Subrahmanya-Bhide/Viscometer-design-Project/Metrology Task Presentation.pdf

## AE242 : METROLOGY AND COMPUTER AIDED INSPECTION

DESIGNING AND MANUFACTURING OF A VISCOMETER

Amruth N(SC18B003), Mihir Kaswan(SC18B015), Pallav Kumar(SC18B018), Siddharth J Gantawar(SC18B029), Subrahmanya V Bhide(SC18B030).

INDIAN INSTITUTE OF SPACE SCIENCE AND TECHNOLOGY

10 May 2020

The viscosity of a fluid is a measure of its resistance to deformation at a given rate. A measure of viscosity called the coefficient of viscosity (denoted by µ) is defined as the slope of the curve between shear stress and rate of shear strain (between fluid layers)

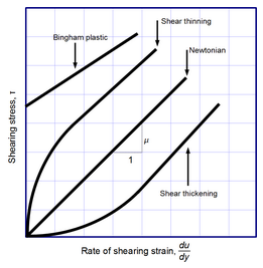
[picture p1: figure]

It is an important property of any fluid and has major implications in a variety of situations for instance the boundary layer concept which occurs in flow of air over a wing, internal flows of liquids and gases in heat exchangers and variety of other applications.

## Methodology

The methodology used by us to measure viscosity is based on the relation obatined below-Consider two cylinders one hollow and the other one solid, as shown in the below figure.

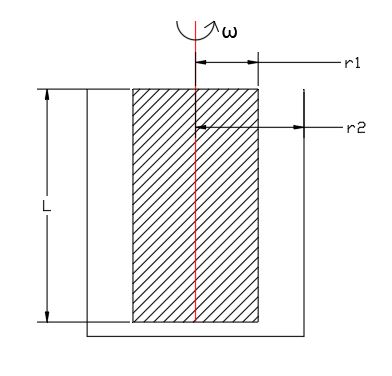
[picture p2: figure]

The radius of the inner and outer cylinder are r1 and r2 respectively. The height of the liquid being L.

When a liquid is introduced between these cylinders and the inner solid cylinder is rotated at a particular angualr speed (ω). The liquid as a virtue of its viscosity would resist the rotation of the cyliner and hence a torque msut be applied by the motor.

shear stress = µ

du
dy | (1)

shear stress = µ

ωr1
r2 − r1

(2)

dF = µ

ωr1
r2 − r1
r1Ldθ | (3)

Hence we get

τ =

Z r2

r1

rdF = µ

ωr

2
1
r2 − r1
2πr1L | (4)

Thus we get the expression

τ =

µωr

3/1 2πL
r2 − r1

(5)

Hence the expression for µ is obatined as

µ = τ

r2 − r1
ωr

3/1 2πL

(6)

## Components of the Viscometer

I NEMA 17 STEPPER MOTOR and corresponding STEPPER MOTOR DRIVER
I LOAD CELL and HX711 AMPLIFIER
I COUPLING
I INNER and OUTER CYLINDER
I PRONY BRAKE
I ARDUINO UNO
I THRUST BEARING

## PRONY BRAKE SYSTEM

I Prony Brake is a system that comprises of two blocks with semi circluar slots that together hold a shaft.
I It applies dry friction on the shafts and due to the reaction force the prony brake spins.
I By measuring the force at the free end of the prony brake using a load cell and knowing the length of the prony brake, it is possible to find the torque applied by the shaft. (https://www.youtube.com/watch?v=NIpspXaPVcs)

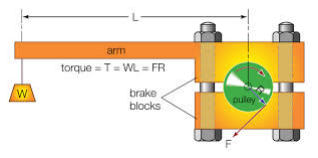
[picture p3: figure]

NEMA 17 stepper motor would be used to rotate the inner cylinder at a constant angular speed.
Specifications:
I Step Angle: 1.8

◦

I Current: 1.2 A/Phase
I Holding Torque: 5.6 kg-cm I Lead Wires: 4
I Shaft diameter: 5 mm

A TB6560 Stepper Motor Driver would be used to interface the stepper motor alog with the current source.
Specifications:
I Rated output: ± 3A ,peak 3.5A.
I Excitation Mode: synchronizing, half step, 1/8 step, 1/16 step, a maximum of 16 segments.
I Working voltage: DC 10V-35V

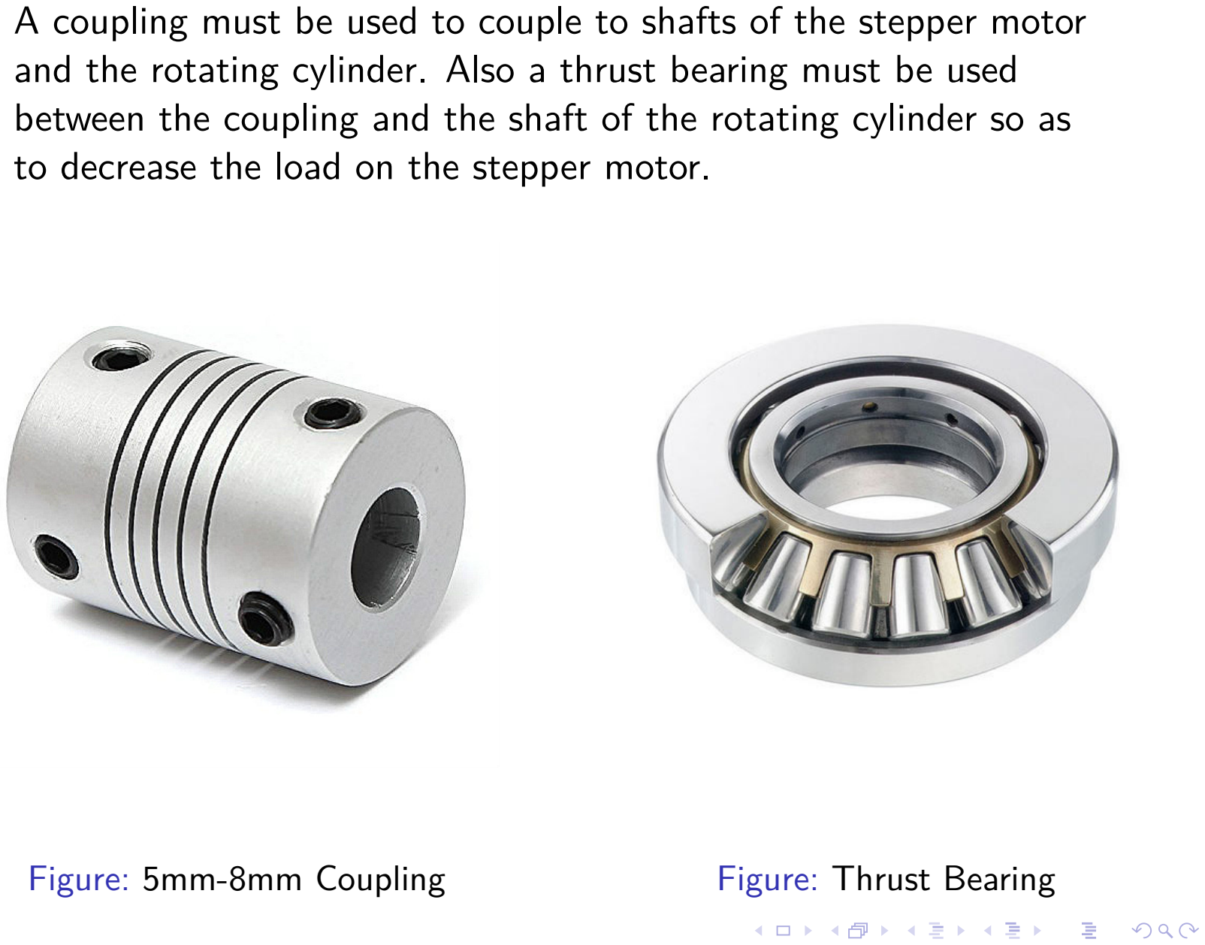
[picture p4: page 9]

A coupling must be used to couple to shafts of the stepper motor and the rotating cylinder. Also a thrust bearing must be used between the coupling and the shaft of the rotating cylinder so as to decrease the load on the stepper motor.

Figure: 5mm-8mm Coupling | Figure: Thrust Bearing

A Load cell would be used to measure the force and hence torque through the prony brake. Specifications:
I Total Size: 8 x 1.3 x 1.3cm / 3.1" x 0.5" x 0.5"(L*W*T)
I Rated Load: 0-5Kg

Also HX711 is a 24 bit ADC which load cell and is connected in between the load cell and the arduino.
The drawings of the inner cylinder, outer cylinder, the two parts of the prony brake, outer cover and the top cover are shown in the following slides respectively.

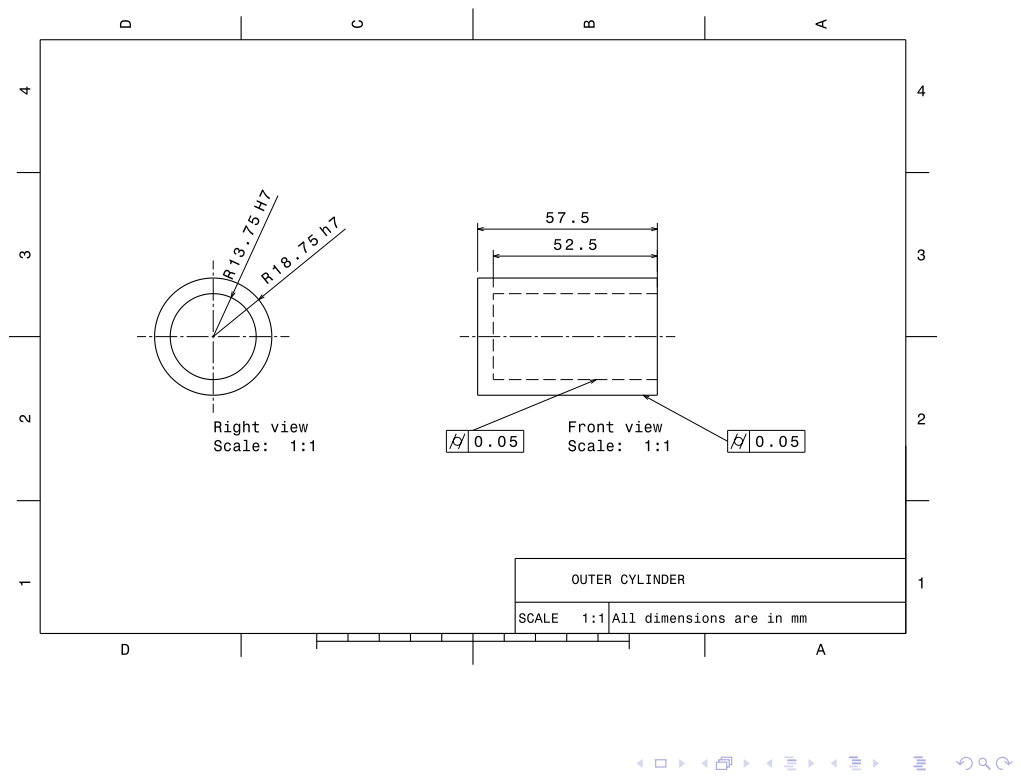
[picture p5: page 11]

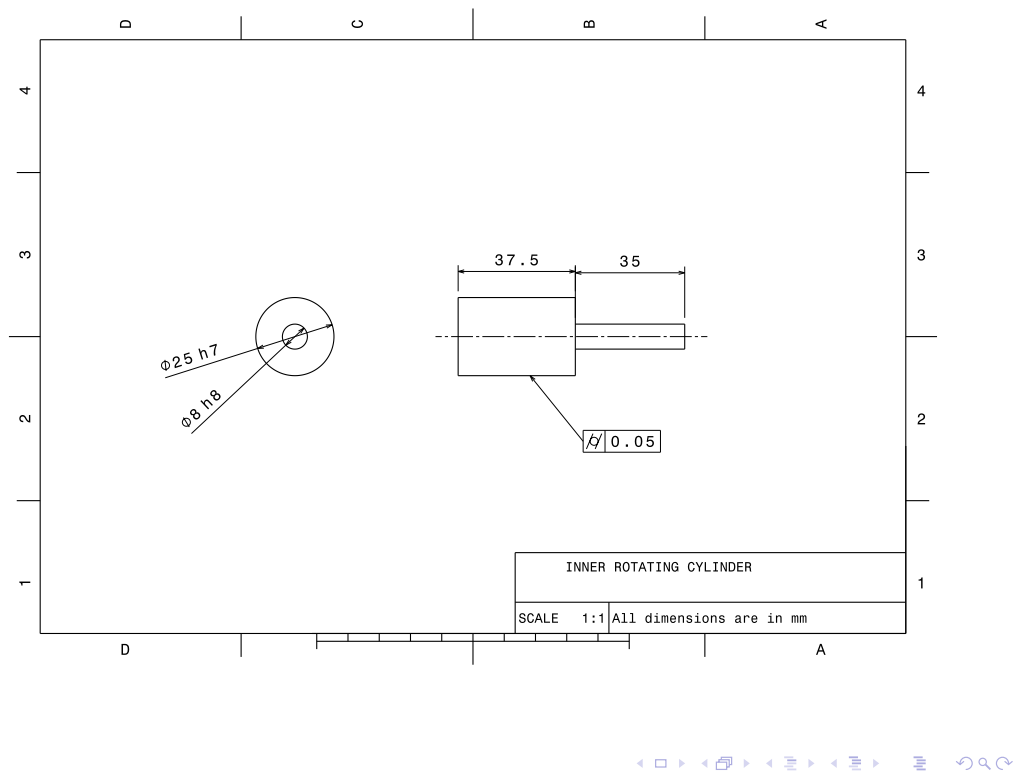
[picture p6: page 12]

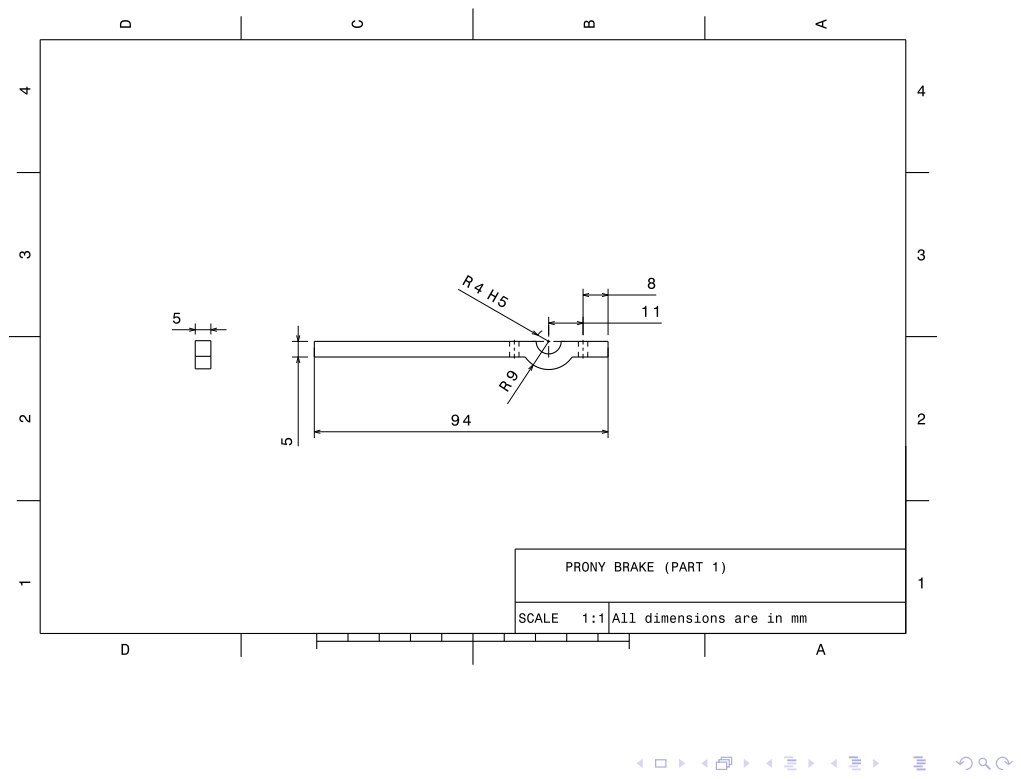
[picture p7: page 13]

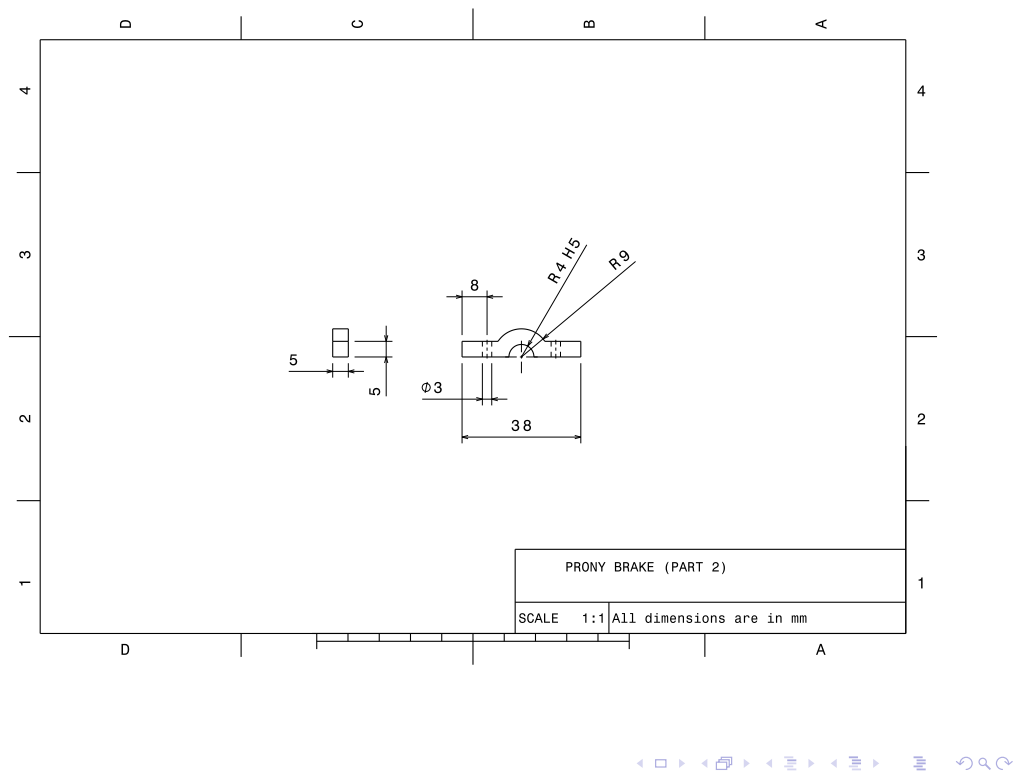
[picture p8: page 14]

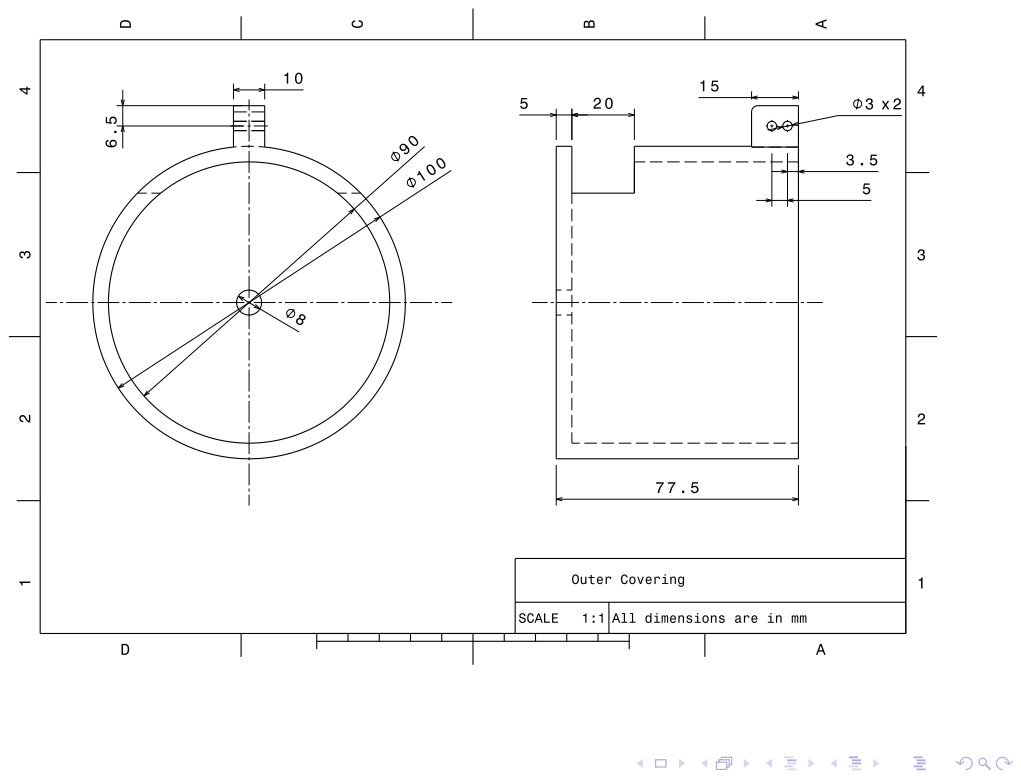
[picture p9: page 15]

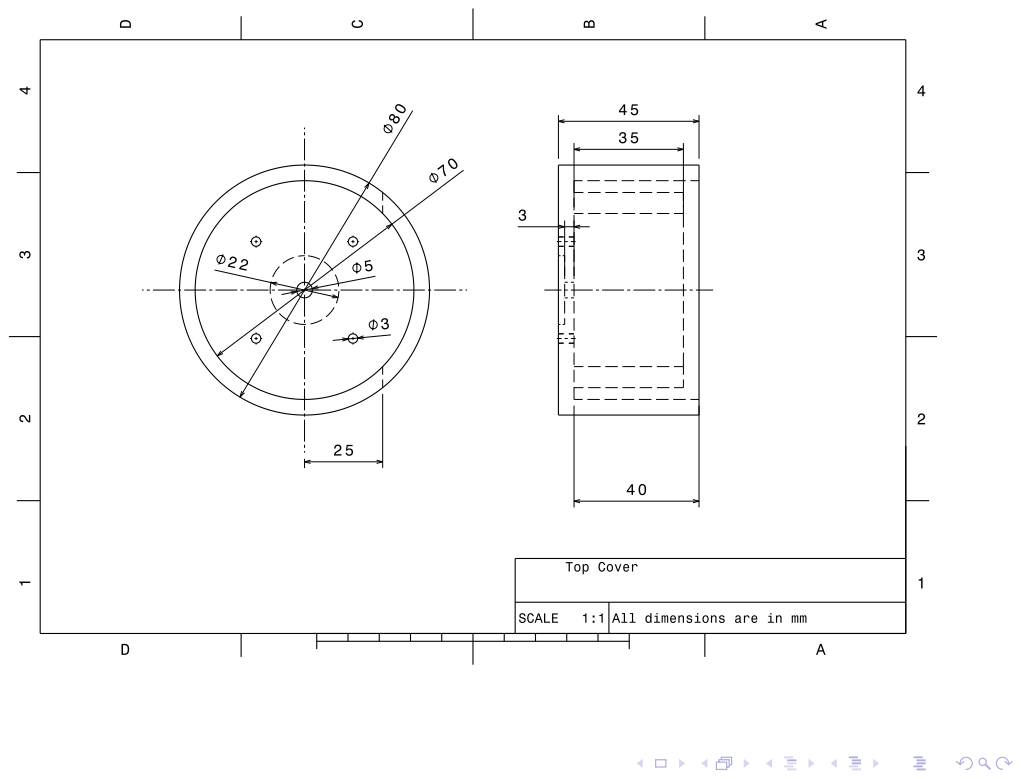
[picture p10: page 16]

## MANUFACTURING

I The inner and outer cylinder of the viscometer can be made of aluminum. By the use of lathe and the drilling operation the geometries required can be manufactured from aluminum shafts of suitable diameters.
I The prony brake parts can be 3D printed.
I The top and the outer cover can be made from pipes of preferably Mild Steel of suitable diameters by cutting them to the specified dimensions.

## ASSEMBLY

I The stepper motor shaft is connected to the shaft of the inner cylinder with the help of a coupling, through a thrust bearing fixed on the outer covering.
I The Prony Brake is connected to the shaft and is free to rotate. At the other end of the prony brake the load cell is placed whose other end is attached to the outer cover.
I The stepper motor is fixed onto the top cover.
I L shape connectors are welded to the top cover, outer cover and the outer cylinder on two opposite sides of the geometry. I With the help of the welded L-shape connectors the top cover is joined with the outer cover. Both the outer cylinder and the outer cover are connected to a wooden base board through the welded connectors.
The schematic of the assembly is as shown.

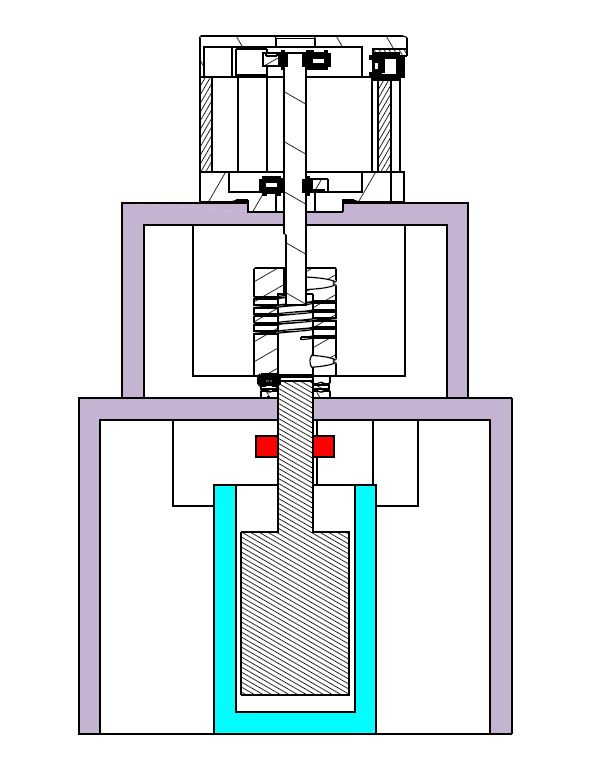
[picture p11: figure]

Figure: Sectional View of the setup

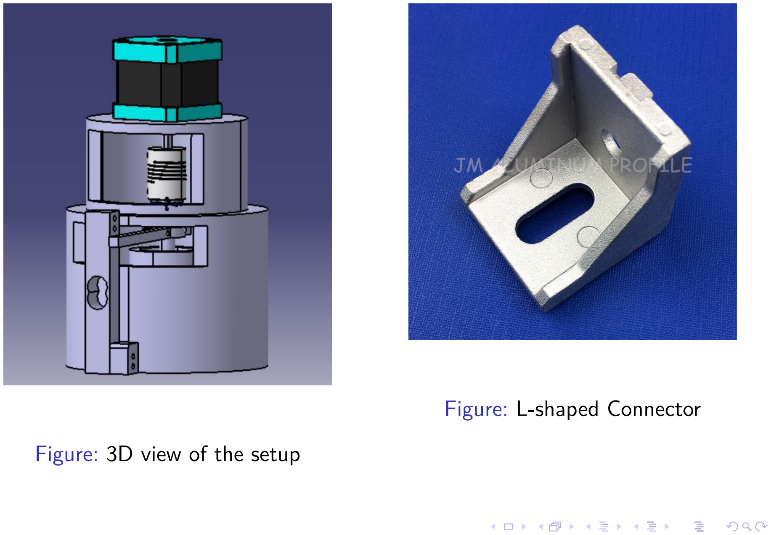
[picture p12: page 20]

Figure: 3D view of the setup

Figure: L-shaped Connector

## WORKING

I The test sample (liquid) must introduced in between the cylinders.
I The Stepper motor must be switched on and is made to rotate at a constant angular velocity.
I The shaft of the inner cylinder which is connected to the motor shaft through a coupling rotates.
I The fluid has some viscosity and hence it resists the rotation due to which to continue to rotate at the same angular speed the motor applies a torque.
I The prony brake helps us measure this torque through the load cell.
I With all the variables of the expression 6 we find the coefficient of viscosity.

## CALIBRATION

The load cell is calibrated in the following way:
I The circuit is made according to the diagram shown in the next slide.
I The load cell is fixed on one end and at the other end a known weight in the form of standard weights is applied.
I The reading from the load cell is taken which would be in mV. I The calibration factor is found using the formula
calibration factor =

applied weight
load cell reading kg/mV
I This must be repeated with several weights and the average value of the calibration factor must be considered.
I Thus the load on the load cell would be :
Load = calibration factor x load cell reading kg.

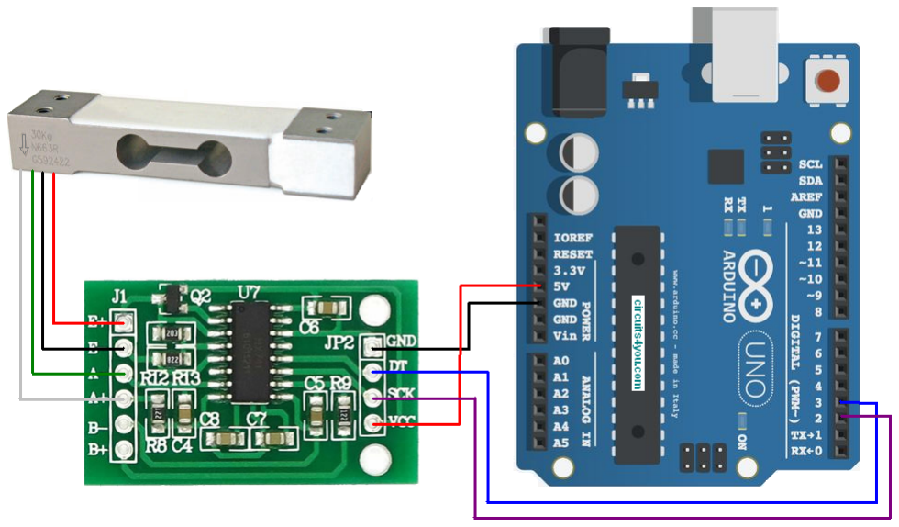
[picture p13: figure]

Figure: Circuit diagram for the calibration process of the Load Cell

The Calibration factor of the Viscometer ’C’ is found in the following method: (https://www.westgard.com/lesson14.htm)
I We must perform experiments using liquids of known viscosities and find the value of µ using the expression 6. I C for this experiment is C =

µactual
µexperimental
I In the following way further experiments must be conducted using the same liquid as well as using other liquids of known viscosities.
I After the experimentation we will have a large number of values for the Calibration Factor ’C’.
I We then find the mean and the standard deviation of C

0
i

s.
I Then based on the results we set the control limits(cl) for the Calibartion factor. Usually it is taken to be the standard deviation but it can also vary.
I After this we can report the Calibration factor for the machine as C = Cmean ± cl where Cmean is the mean of C

0
i

s.

The different values of variables and the least counts of our measuring instruments are as follows:
I r1 = 12.5mm
I r2 = 13.75mm
I L = 37.50mm
I max torque supported by the stepper motor (holding torque) = 5.6kg-cm = 0.55 Nm.
I ω = In the range of 100-500 rpm
I Least count of the Load cell (https://electronics.stackexchange.com/questions/222035/what-is-the-measurement-resolution-of-my-load-cell) =

1
2

24 x5kg = 3x10⁻⁷kg.

Considering all this using expression 6 we can expect to find µ upto 179 Pa.s And considering the least count of the load cell the least value of 9.56x10⁻⁵ Pa.s can be measured by the viscometer.

The prony brake system even though effective has some drawbacks:
I The prony brake is a hanging cantiliver which can bend over time and affect results.
I The system is a mechanical one and it will have losses which can’t be accounted easily.
I Due to this we can’t ensure repeatability and reproducibility of the experiment and the results.
I Another reason for non repeatability is that the central part of the system is the fact that the friction force acts equally and opposite to the shaft and the prony brake. There can be some slipping in this case and to prevent this precautions have to be taken.
Hence another alternative for the prony brake system is the use of a electronic torquemeter which wouldn’t have such issues as mentioned above.
The UTM II (https://www.unipulse.tokyo/en/product/utm-ii-w-2/) a torquemeter has a larger range of measurable torque, 0.05Nm to 10,000Nm and a resolution of 1/10000 which is better than the Prony brake arrangement.

## REFERENCES

1. https://www.youtube.com/watch?v=NIpspXaPVcs
2. https://www.westgard.com/lesson14.htm
3. https:
//electronics.stackexchange.com/questions/222035/ what-is-the-measurement-resolution-of-my-load-cell (https://electronics.stackexchange.com/questions/222035/what-is-the-measurement-resolution-of-my-load-cell)
4. https://www.unipulse.tokyo/en/product/utm-ii-w-2/
