Subrahmanya-Bhide/Viscometer-design-Project/(list of files, cad)

Other CAD files:
Visco.CATProduct
